IoTCloudStudio/HW_Develop/Productivo/Comunicador Connect/Configuracion OpenWRT/Migracion Claro MF193/LEEME.txt

========================================================================
 MIGRACION DE ROUTER A 3G (Claro)  -  ZTE MF193  -  por QMI
========================================================================

Para el tecnico en el sitio (NO necesita internet):

  1. Conecte la PC por WiFi a la red del router.
  2. Abra esta carpeta y haga doble clic en  INSTALAR.bat
  3. Responda lo que pregunta la ventana negra:
       - IP del router  -> si no sabe, apriete ENTER (usa 192.168.1.1)
       - Operador       -> 1 = Claro (por defecto)
     La contrasena del router va incluida: normalmente NO hay que escribir
     nada mas. Solo la pide si el router tiene otra contrasena.
  4. Espere unos 3-6 minutos SIN cerrar la ventana. El router configura el
     modem por QMI y prueba el 3G solo; el instalador se reconecta para ver
     como salio (mientras aparecen puntos "...", es normal).
     Al final dice "EL ROUTER NAVEGA POR 3G (QMI...)" o, si algo fallo,
     que hacer.

CONEXION POR WiFi: si la PC se desconecta de la red del router y NO vuelve
sola, reconectala a mano; la ventana sigue esperando. Si ya se cerro o dio
timeout, hace doble clic en  VER-RESULTADO.bat  : se reconecta y te dice
como salio, sin reinstalar nada.

Si Windows pregunta por "plink.exe" o "pscp.exe" (son de PuTTY, estan
firmados): permitir la ejecucion.

SI ALGO FALLA, SIMPLEMENTE VOLVE A HACER DOBLE CLIC EN INSTALAR.bat.
El instalador trabaja por etapas (paquetes / script / interfaz 3G / conexion
/ VPN) y cada una se valida contra el estado real del router, no contra lo
que paso la vez anterior. Lo que ya quedo bien NO se vuelve a instalar ni se
reconfigura - solo se reintenta lo que todavia no esta validado. Al final
siempre aparece el detalle etapa por etapa; si falta algo, el mensaje te
dice exactamente cual volver a intentar.
Si ves "YA HAY UNA INSTALACION EN CURSO": no se hizo nada mal, es que el
router todavia esta terminando la corrida anterior (u otra ventana del
instalador esta activa). Esperá 2-3 minutos y usá VER-RESULTADO.bat.

Si termina con problema: al lado de INSTALAR.bat queda un archivo
  instalacion-AAAAMMDD-HHMMSS.log
Mande ESE archivo a soporte. El router NO se retira: la configuracion
anterior queda respaldada dentro del router en
  /etc/config/network.original-antes-de-instalar

------------------------------------------------------------------------
 Que deja instalado en el router
------------------------------------------------------------------------
  - Modulos QMI (kmod-usb-net-qmi-wwan + deps) y el binario uqmi.
  - /usr/sbin/mf193-qmi  : conecta el modem por QMI y lo vigila.
      * en el arranque (rc.local) hace 'mf193-qmi connect'
      * cron cada 4 min hace 'mf193-qmi watch': si no hay internet
        reconecta, y si falla 3 veces seguidas REINICIA el router.
  - Interfaz 'wan3g' = proto 'dhcp' sobre 'wwan0', en la zona wan del
    firewall. netifd hace el DHCP, la ruta y el DNS.

------------------------------------------------------------------------
 Contenido de la carpeta
------------------------------------------------------------------------
  INSTALAR.bat          Lo unico que se toca (doble clic).
  VER-RESULTADO.bat     Solo re-lee como salio (si el WiFi se corto).
  instalar.ps1          Logica de la PC (PowerShell). Los .bat la lanzan.
  tools/                plink.exe + pscp.exe (PuTTY 0.85, sin instalar).
  mf193-offline-pkgs/   Se copia al router y se instala ahi, sin red:
                          - uqmi, qmi.sh, mf193-qmi
                          - kmods QMI + usb-modeswitch (.ipk)
                          - install-offline.sh (corre en el router)

------------------------------------------------------------------------
 Datos / notas
------------------------------------------------------------------------
- Router : TL-MR3020 v3  |  OpenWrt 22.03.0  |  target ramips/mt76x8
- Modem  : ZTE MF193 (arranca en modo 'factory_test'; se destraba por QMI
           con 'set-device-operating-mode online'). NO conecta por PPP.
- APN    : Claro = igprs.claro.com.ar (sin usuario/clave)
- PC     : Windows 10/11. NO necesita "Cliente OpenSSH" (usa tools/).
- Contrasena SSH del router (de fabrica): 3gC0nn3ct!
- Los .ipk/uqmi son de ESTE target (ramips/mt76x8, kernel 5.10.138). Otro
  modelo de router -> rearmar mf193-offline-pkgs/ con lo de ese target.
