IoTCloudStudio/HW_Develop/Productivo/Comunicador Connect/Documentacion tecnica/3G-Connect-MellanoSeguridad_V1.0.pdf

# Documento Técnico

## VPN Mellano Seguridad Versión: 1.00 - Fecha: 29-09-2022

## Descripción del documento

Este documento tiene como objetivo informar y documentar la VPN extendida a Mellano Seguridad como así también los parámetros configurados en los comunicadores 3G Connect.

## Detalle de la configuración Servidor

Se debera utilizar el soft: https://openvpn.net/community-downloads/

Cargar el certificado y usar las siguientes credenciales:

## OpenVPN

| Username | Password
Servidor | Mellano_server | DamianMe11ano2022

*** Recordar que con estas credenciales se puede acceder de a 1 Pc por vez

## Detalle de la configuración Comunicadores

IPs externos: 10.2.2.XXX

*** Donde XXX son los ultimos 3 numeros de la terminación de la etiqueta (SN situado en la zona inferior de los equipos)

Rango IP internos (Posee DHCP): 192.168.0.2-192.168.0.254

## WiFi

SSID | Password
IoTCloud-MellanoSeguridad | m3114n0s3gur1d4d

Servicios

Servicio | Puerto Externo | IP interno | Puerto Interno
Zkteco Viejas | 4370 | 192.168.0.10 | 4370
| 4371 | 192.168.0.11 | 4370
| 4372 | 192.168.0.12 | 4370
| 4373 | 192.168.0.13 | 4370
Zkteco Nuevas | 8088 | 192.168.0.10 | 8088
| 8089 | 192.168.0.11 | 8088
| 8090 | 192.168.0.12 | 8088
| 8091 | 192.168.0.13 | 8088
