IoTCloudStudio/HW_Develop/Productivo/Cloud UPS/Brochure/FOLLETO CLOUD UPS.png

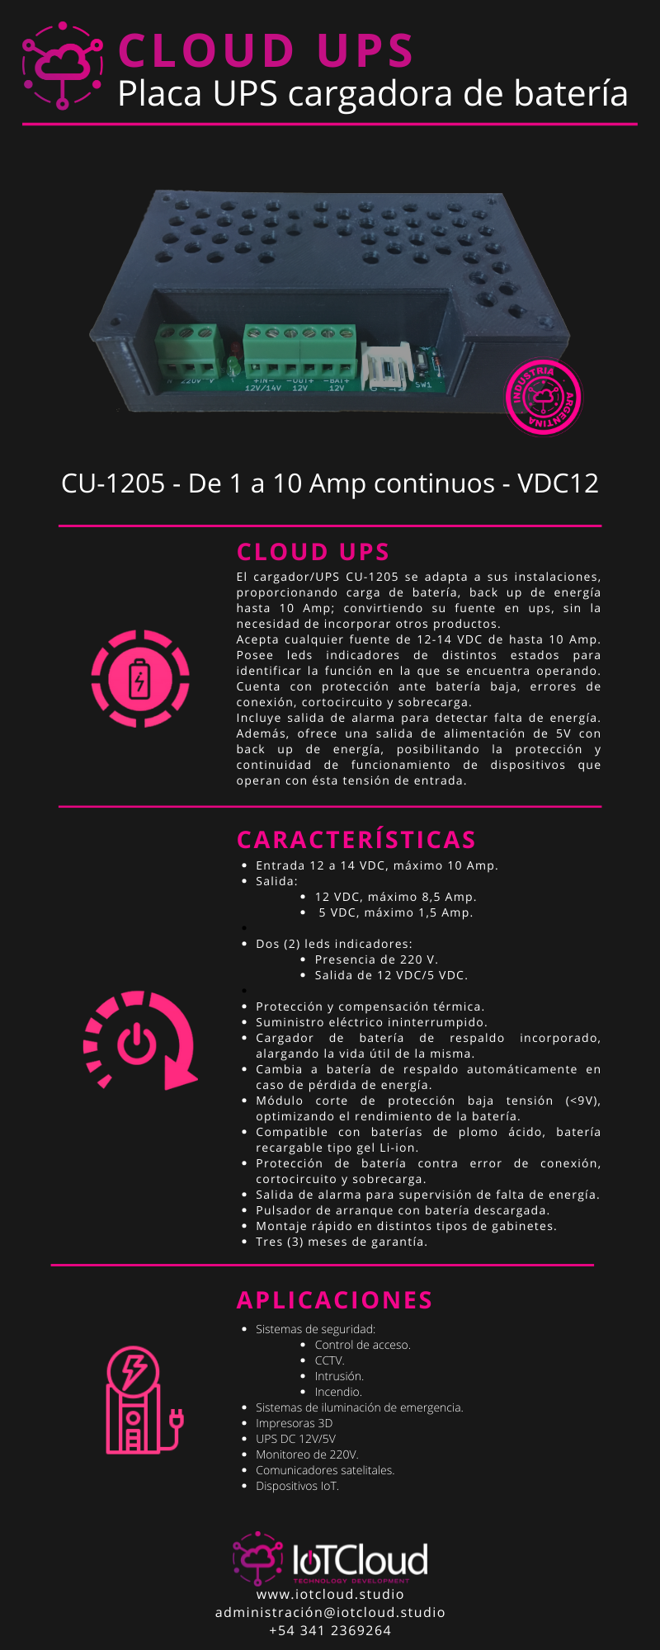
Productivo/Cloud UPS/Brochure/FOLLETO CLOUD UPS.png
