IoTCloudStudio/HW_Develop/Productivo/Comunicador Connect/Case/PNG/44cd3f2919015212b32772a9f72a4f9e.png

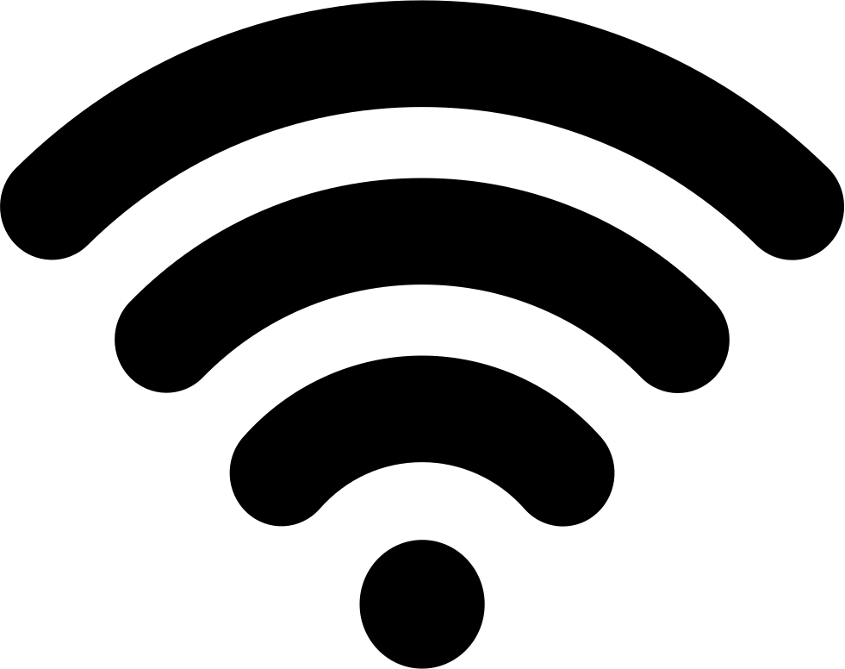
Productivo/Comunicador Connect/Case/PNG/44cd3f2919015212b32772a9f72a4f9e.png
