IoTCloudStudio/HW_Develop/Productivo/Comunicador Connect/Case/PNG/3753385.png

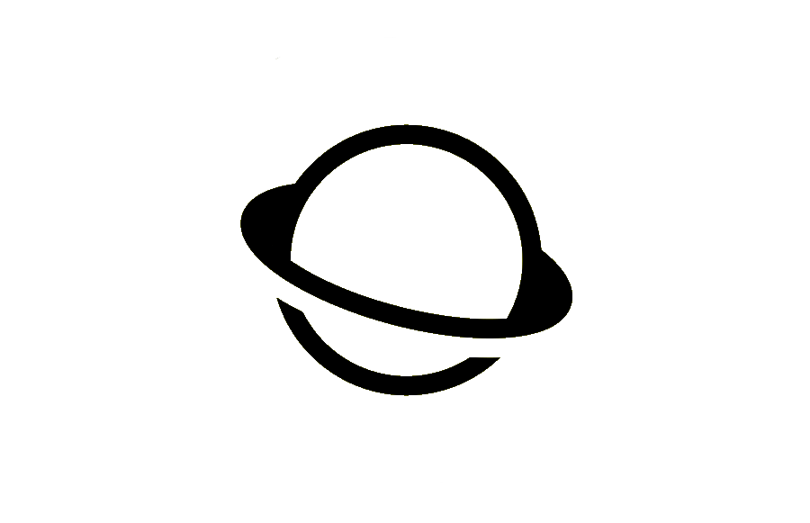
Productivo/Comunicador Connect/Case/PNG/3753385.png
