IoTCloudStudio/HW_Develop/Productivo/Comunicador Connect/Case/PNG/g3762.png

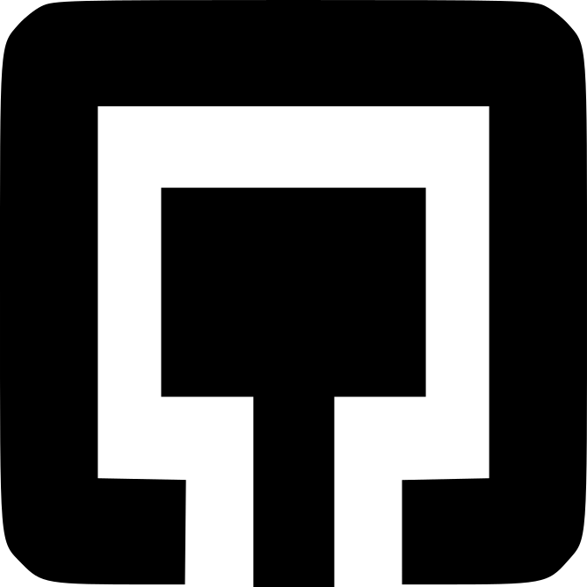
Productivo/Comunicador Connect/Case/PNG/g3762.png
