IoTCloudStudio/HW_Develop/Testing/Control de Acceso/lista componentes.xls

Sheet: Sheet1
 |  | cant | $/unid | iva | $ total s/iva | $ total c/iva | STOCK
R1, R2, R7, R8 | 2K2 | 4 | 3.3 | 21 | 13.20 | 15.97 | 59
R3 | 330 | 1 | 3.3 | 21 | 3.30 | 3.99 | 90
R4, R5 | 68K 2W | 2 | 13.2 | 21 | 26.40 | 31.94 | 8
R6 | 180 | 1 | 3.3 | 21 | 3.30 | 3.99 | 90
R9, R10, R11 | 10K | 3 | 3.3 | 21 | 9.90 | 11.98 | 55
RV1, RV2 | Trimmer 10k | 2 | 115.5 | 21 | 231.00 | 279.51 | 18
C1, C2 | 100 nF | 2 | 5.632 | 21 | 11.26 | 13.63 | 12
C3 | 33 uF | 1 | 8.03 | 21 | 8.03 | 9.72 | 8
C3 | 1 uF | 1 | 4.6816 | 21 | 4.68 | 5.66 | 12
D1 | Puente W10M | 1 | 33.44 | 10.5 | 33.44 | 36.95 | 2
D2, D6, D10 | 1n4148 | 3 | 0.99 | 10.5 | 2.97 | 3.28 | 0
D3, D4 | 1n5408 | 2 | 15.1492 | 10.5 | 30.30 | 33.48 | 6
D5 | Led verde | 1 | 5.808 | 10.5 | 5.81 | 6.42 | 10
D7 | Led rojo | 1 | 5.72 | 10.5 | 5.72 | 6.32 | 10
D8 | Zener 11V | 1 | 4.928 | 10.5 | 4.93 | 5.45 | 0
D9 | Zener 6,8V | 1 | 4.9247 | 10.5 | 4.92 | 5.44 | 0
Q1 | IRF630N | 1 | 121 | 10.5 | 121.00 | 133.71 | 0
Q2, Q3 | BC548 | 2 | 5.984 | 10.5 | 11.97 | 13.22 | 8
Q4 | BC557 | 1 | 6.105 | 10.5 | 6.11 | 6.75 | 15
K1 | Rele 2 Inv | 1 | 110 | 21 | 110.00 | 133.10 | 3
K2 | Rele 1 Inv | 1 | 154 | 21 | 154.00 | 186.34 | 23
U1 opto | PC817 | 1 | 28.6 | 10.5 | 28.60 | 31.60 | 2
U2 (zocalo) | Zocalo dip 8 | 1 | 5.5 | 21 | 5.50 | 6.66 | 0
U3 reg | LM7805 | 1 | 40.7 | 10.5 | 40.70 | 44.97 | 7
SET1 | PULSADOR | 1 | 11 | 10.5 | 11.00 | 12.15 | 5
 | BORNERA x3 | 3 | 52.8 | 10.5 | 158.40 | 175.03 | 45
 | HEADER 90 x4 | 1 | 5.984 | 21 | 5.98 | 7.24 | 10
U2 (chip) | NE555 | 1 | 22 | 10.5 | 22.00 | 24.31 | 0
 | DISIPADOR 555 | 1 | 53 | 21 | 53.00 | 64.13 | 3
 | DISIPADOR IRF | 1 | 53 | 21 | 53.00 | 64.13 | 2
 | HOUSING x4 | 1 | 3.426 | 21 | 3.43 | 4.15
 | Pines p/housing | 4 | 1.98 | 21 | 7.92 | 9.58 | 100
total |  |  |  |  | 1191.77 | 1390.81

Sheet: Sheet2
 | Caracteristica | Cantidad
Cap ceramico | 100nF | 50
Cap electr radial | 1uF 63v 5x11 | 20
Cap electr radial | 33uF 63v 8x12 | 20
Puente rectificador | W10M | 25
Diodo | 1n4148 | 100
Diodo | 1n5408 | 50
Led | 3mm Verde difuso | 20
Led | 3mm Rojo difuso | 20
Diodo zener | 11v 1/2w | 25
Diodo zener | 6v8 1/2w | 25
Rele | S. inv. 12V 10A | 20
Rele | D. inv. 12V 1A | 20
Mosfet | IRF630 | 23
Transistor | BC548B | 40
Transistor | BC557 | 10
Resistencia metal-film | 2k2 1/2w | 100
Resistencia metal-film | 10k 1/2w | 100
Resistencia metal-film | 68k 2w | 50
Llave tact switch | mini 5.1mm 2 patas | 25
Optoacoplador | PC817 | 25
Circuito integrado | NE555 | 30
Regulador de voltaje | LM7805 | 20
Header | .1' 90° Macho 4 vias | 20
Terminal crimpeable | p/ housing .1' 1 cara de contacto | 100
Trimpot cermet 1 vuelta | 10k horizontal | 50
Zocalo para C.I. | 2x4 | 25
Bornera apilable verde | 3 polos 10a (tornillo ranura plana) | 60
