IoTCloudStudio/HW_Develop/Productivo/Cloud UPS/Imagenes/PCB v1.0 - Materiales.jpg

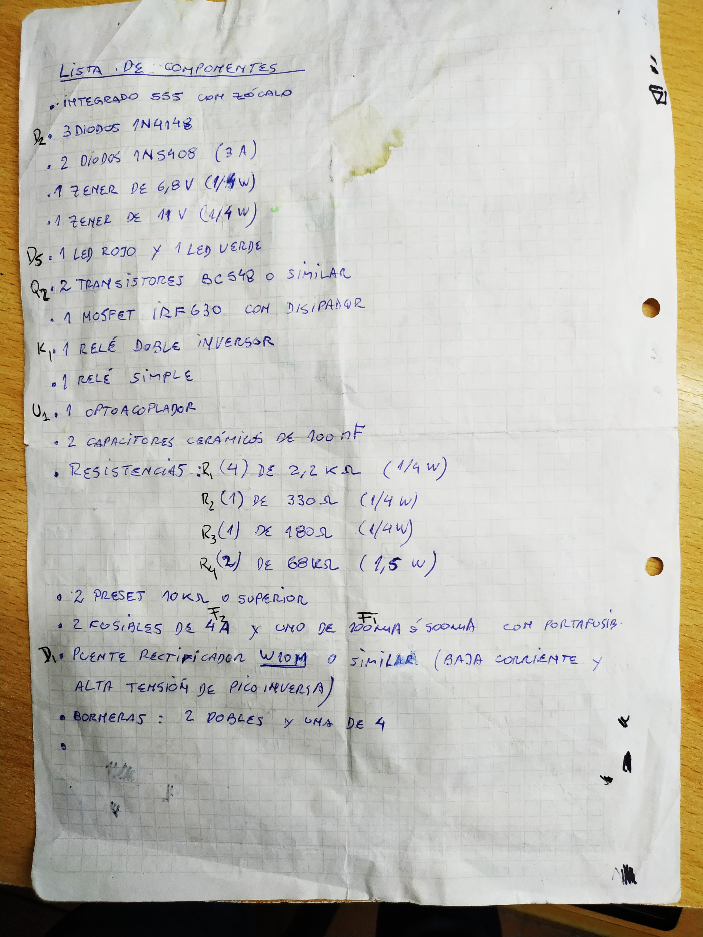
Productivo/Cloud UPS/Imagenes/PCB v1.0 - Materiales.jpg
