IoTCloudStudio/HW_Develop/Productivo/Cloud UPS/Case/tapa upsV1.3.STL

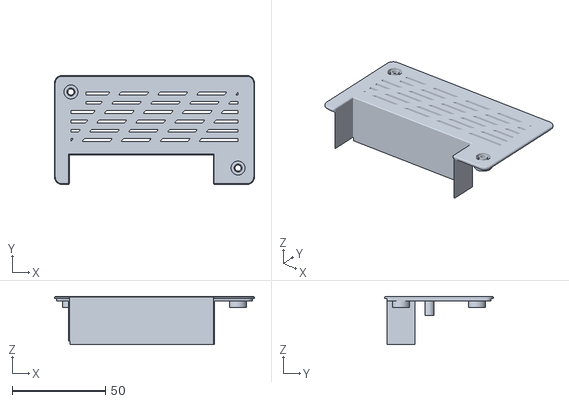
[picture p12: CAD file, 2022-12-19]
Productivo/Cloud UPS/Case/tapa upsV1.3.STL
107.0 x 58.3 x 25.7
