IoTCloudStudio/HW_Develop/Testing/Control de Acceso/PCB_control_acceso/PCB_control_acceso-B_Cu.dxf

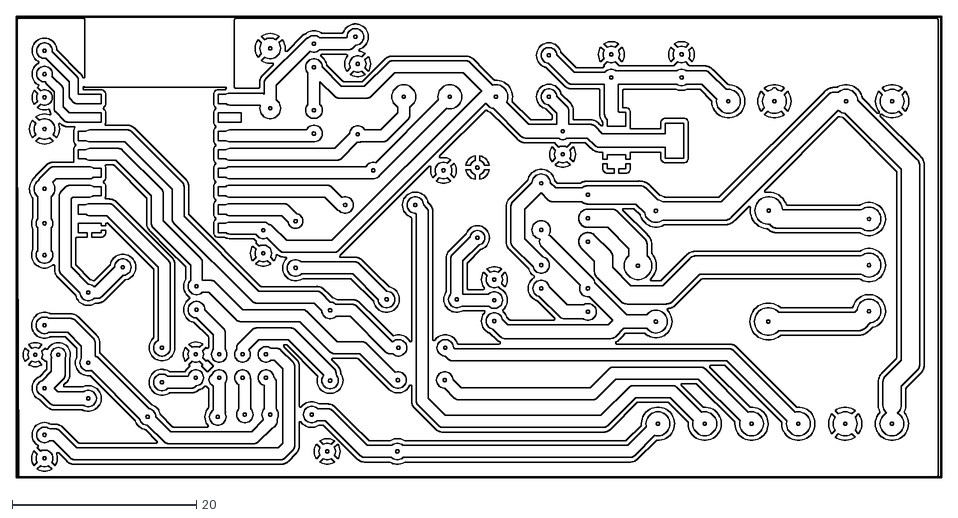
[picture p13: CAD file, 2024-07-27]
Testing/Control de Acceso/PCB_control_acceso/PCB_control_acceso-B_Cu.dxf
100.4 x 50.1
