IoTCloudStudio/HW_Develop/Productivo/Cloud UPS/Case/base ups.SLDPRT

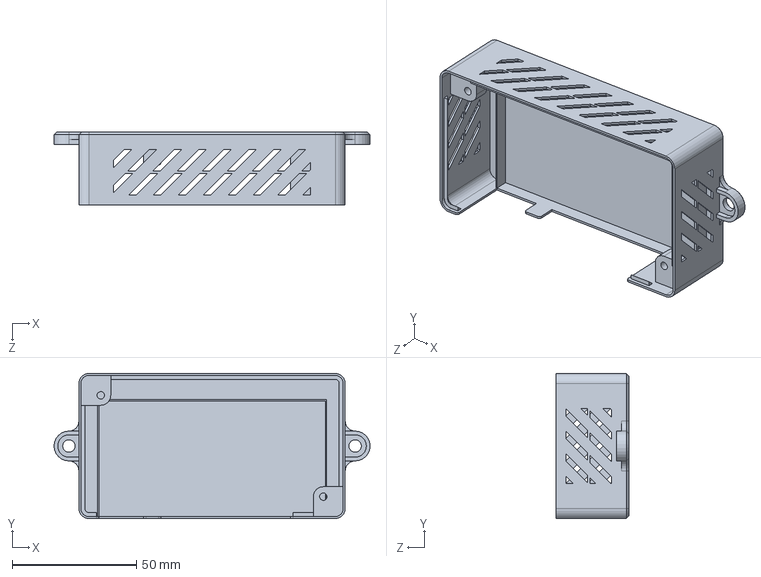
[picture p14: CAD file, 2022-12-19]
Productivo/Cloud UPS/Case/base ups.SLDPRT
127.0 x 58.3 x 29.2 mm
