IoTCloudStudio/HW_Develop/Productivo/Cloud UPS/Case/tapa ups.STL

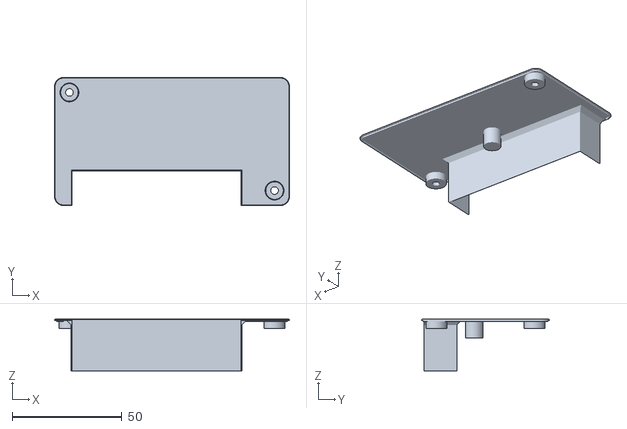
[picture p15: CAD file, 2022-12-19]
Productivo/Cloud UPS/Case/tapa ups.STL
107.0 x 58.3 x 23.6
