IoTCloudStudio/HW_Develop/Productivo/Comunicador Connect/Case/iot3g_chico.SLDPRT

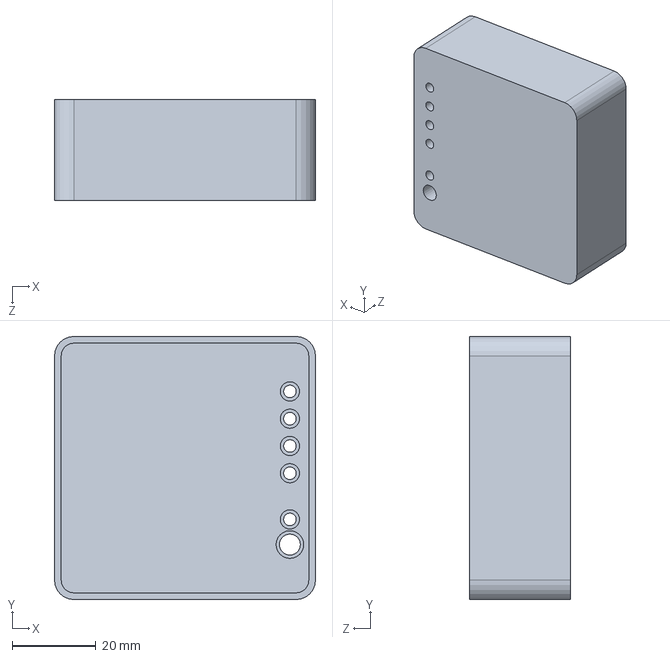
[picture p16: CAD file, 2022-12-19]
Productivo/Comunicador Connect/Case/iot3g_chico.SLDPRT
62.2 x 62.7 x 24.1 mm
