IoTCloudStudio/HW_Develop/Productivo/Comunicador Connect/Case/iot3g-v1-1.SLDPRT

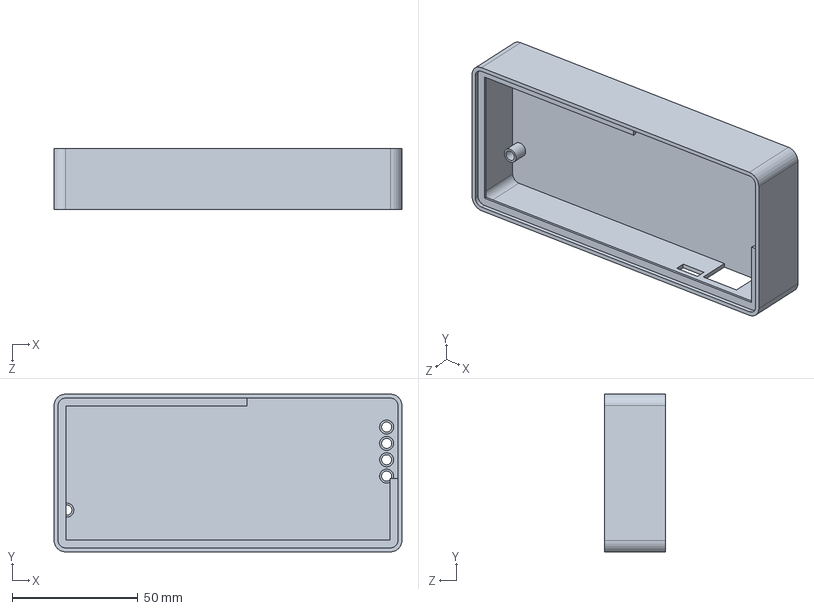
[picture p17: CAD file, 2022-12-19]
Productivo/Comunicador Connect/Case/iot3g-v1-1.SLDPRT
138.2 x 62.7 x 24.1 mm
