IoTCloudStudio/HW_Develop/Productivo/Comunicador Connect/Case/case-3gGrandeV9.STL

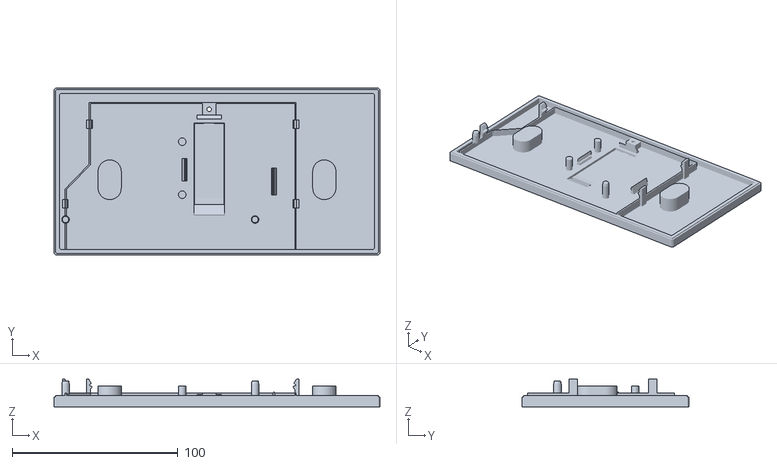
[picture p18: CAD file, 2022-12-19]
Productivo/Comunicador Connect/Case/case-3gGrandeV9.STL
196.8 x 100.8 x 16.7
