IoTCloudStudio/HW_Develop/Productivo/Comunicador Connect/Case/iot3g.SLDPRT

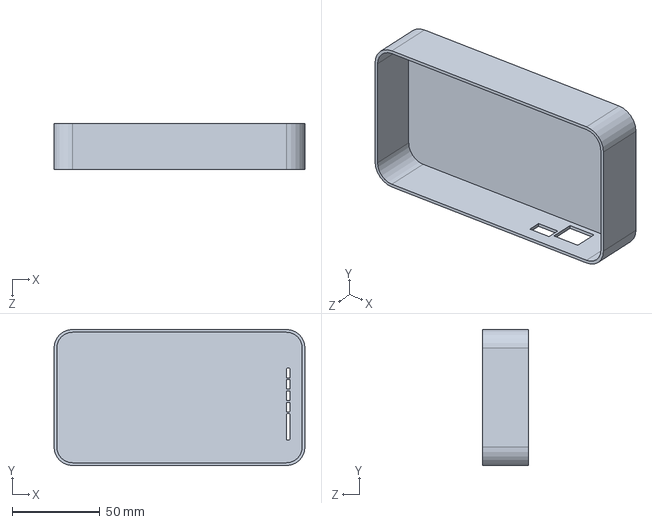
[picture p20: CAD file, 2022-12-19]
Productivo/Comunicador Connect/Case/iot3g.SLDPRT
143.2 x 77.7 x 26.1 mm
