IoTCloudStudio/HW_Develop/Productivo/Comunicador Connect/Case/3giot tapa.stl

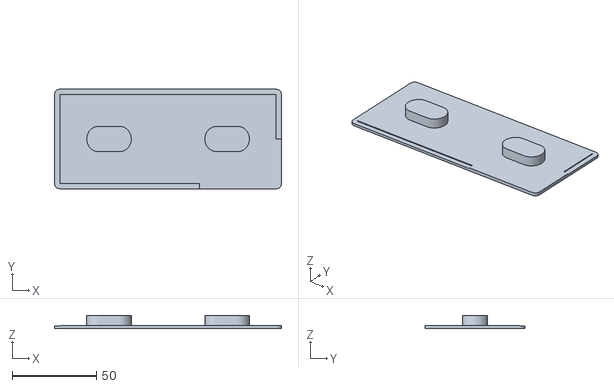
[picture p21: CAD file, 2022-12-19]
Productivo/Comunicador Connect/Case/3giot tapa.stl
134.5 x 59.0 x 7.84
