IoTCloudStudio/HW_Develop/Productivo/Comunicador Connect/Case/case-3gGrandeV9tapa.STL

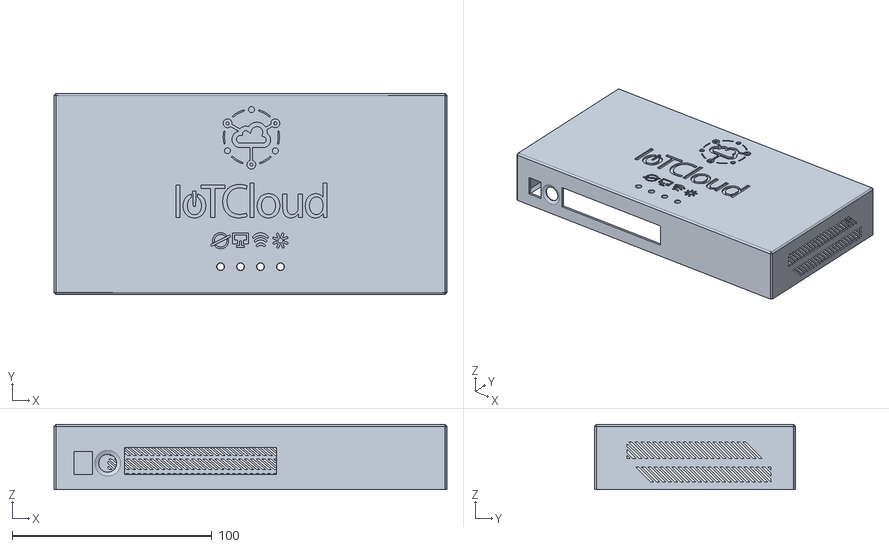
[picture p22: CAD file, 2022-12-19]
Productivo/Comunicador Connect/Case/case-3gGrandeV9tapa.STL
196.8 x 100.8 x 32.6
