IoTCloudStudio/HW_Develop/Productivo/Comunicador Connect/Case/3giot (3).stl

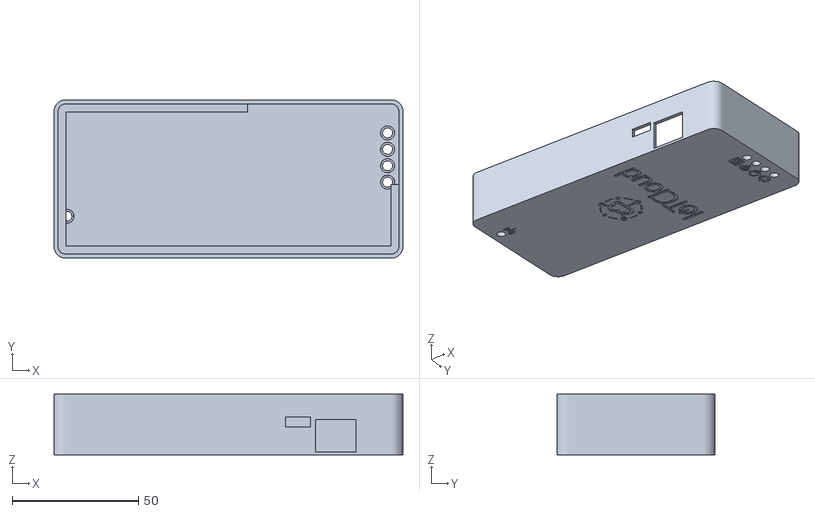
[picture p23: CAD file, 2022-12-19, an earlier design]
Productivo/Comunicador Connect/Case/3giot (3).stl
138.2 x 62.7 x 24.1
