IoTCloudStudio/HW_Develop/Productivo/Comunicador Connect/Case/3giot (4).stl

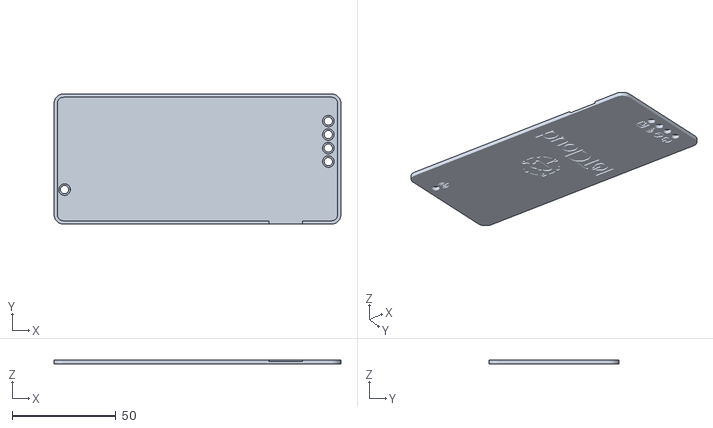
[picture p24: CAD file, 2022-12-19, an earlier design]
Productivo/Comunicador Connect/Case/3giot (4).stl
138.2 x 62.7 x 2.00
