IoTCloudStudio/HW_Develop/(list of files, cad)

Other CAD files:
Productivo/Comunicador Connect/Case/iot3g-v1-0.STL
Productivo/Comunicador Connect/Case/iot3g-nuevo.SLDPRT
Productivo/Comunicador Connect/Case/3giot.stl
Productivo/Comunicador Connect/Case/3giot (5).stl
Productivo/Comunicador Connect/Case/3giot (2).stl
Productivo/Cloud UPS/Case/base ups.STL
Productivo/Comunicador Connect/Case/3giot (1).stl
Productivo/Comunicador Connect/Case/iot3g-v1-1.STL
Productivo/Comunicador Connect/Case/iot3g-v1.0.SLDPRT
Productivo/Comunicador Connect/Case/iot3g-v1.0.STL
Productivo/Comunicador Connect/Case/iot3g-v1.1.STL
Productivo/Comunicador Connect/Case/iot3g.STL
Productivo/Comunicador Connect/Case/iot3g_chico.STL
Testing/Control de Acceso/PCB_control_acceso/PCB_control_acceso-B_Mask.dxf
