IoTCloudStudio/HW_Develop/Testing/Caravana RFID/ESP32_RFID_Reader/extras/antennaFreq.xlsx

Sheet: Sheet1
Antenna Calcs | Value | Units
Required Freq | 134.2 | kHz
Inductor | 0.41 | mH
Required Cap | 3.4 | nF
Actual Cap | 3.4 | nF
Actual Freq | 134.8 | kHz
Equations
Required Cap | 3.430452221
Actual Freq | 134.7996438

Sheet: Sheet2
diameter | 0.11
radius | 5.5
width | 0.5
windings | 44
inductance | 36.48287269
 | 5.885829146
