IoTCloudStudio/HW_Develop/Testing/Harvesting energy/Data/Cleaned_data.xlsx

Sheet: V1_Experiment1-4
Sequence number | Baseline (HEX) | Basline (DEC) | Baseline (From 0) | Exp 1 (HEX) | Exp 1 (DEC) | Exp 1 (From 0) | Exp 2 (HEX) | Exp 2 (DEC) | Exp 2 (From 0) | Exp 3 (HEX) | Exp 3 (DEC) | Exp 3 (From 0) | Exp 4 (HEX) | Exp 4 (DEC) | Exp 4 (From 0)
1 | 0c78 | 3192 | 0 | 0c25 | 3109 | 0 | 0c0c | 3084 | 0 | 0c2c | 3116 | 0 | 0c6b | 3179 | 0
2 | 0c73 | 3187 | -5 | 0c22 | 3106 | -3 | 0c12 | 3090 | 6 | 0c29 | 3113 | -3
3 | 0c6b | 3179 | -13 | 0c1c | 3100 | -9 |  |  |  | 0c43 | 3139 | 23
4 | 0c64 | 3172 | -20 | 0c17 | 3095 | -14 | 0c12 | 3090 | 6
5 | 0c5f | 3167 | -25 | 0c17 | 3095 | -14
6 | 0c5b | 3163 | -29 | 0c17 | 3095 | -14 | 0c07 | 3079 | -5
7 | 0c53 | 3155 | -37 | 0c12 | 3090 | -19
8 |  |  |  | 0c0c | 3084 | -25 | 0c03 | 3075 | -9
9 | 0c4a | 3146 | -46 | 0c09 | 3081 | -28 |  |  |  | 0c7c | 3196 | 80
10 |  |  |  | 0c07 | 3079 | -30
11
12 | 0c3a | 3130 | -62 |  |  |  | 0bf3 | 3059 | -25 | 0c7a | 3194 | 78
13 |  |  |  | 0bf7 | 3063 | -46 | 0bec | 3052 | -32 | 0c75 | 3189 | 73
14 | 0c30 | 3120 | -72 | 0bf7 | 3063 | -46 | 0bf1 | 3057 | -27
15 | 0c2c | 3116 | -76 | 0bf1 | 3057 | -52
16 | 0c25 | 3109 | -83 | 0bee | 3054 | -55
17 | 0c20 | 3104 | -88
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
