IoTCloudStudio/HW_Develop/Testing/Harvesting energy/Data/Raw data/V1/Experiment4_raw.xlsx

Data | Operator | Sequence number | Timestamp
0bd8 | SIGFOX_Denmark_IOTDK | 110 | 24/02/2022 11:52
0bf5 | SIGFOX_Denmark_IOTDK | 103 | 23/02/2022 07:35
0c30 | SIGFOX_Denmark_IOTDK | 80 | 20/02/2022 22:48
0c6b | SIGFOX_Denmark_IOTDK | 63 | 18/02/2022 05:50
0d4f | SIGFOX_Denmark_IOTDK | 1 | 2022-07-02 06:10
 |  |  |  | f
