IoTCloudStudio/HW_Develop/Testing/Caravana RFID/RDM6300/RDM6300_PCB.png

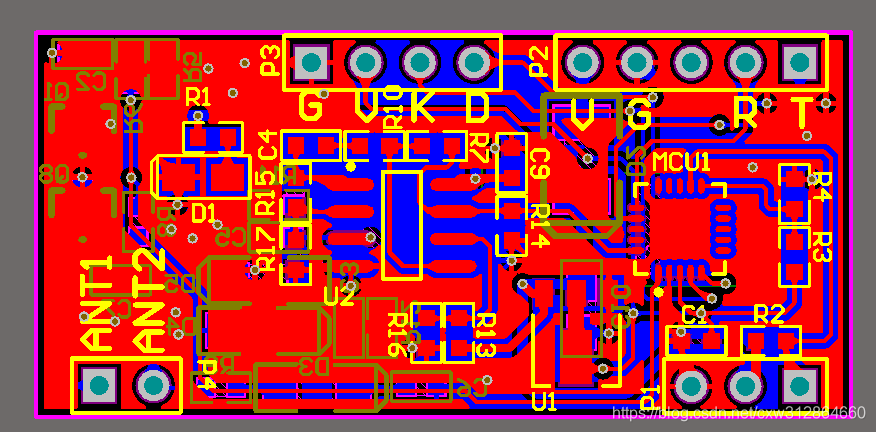
Testing/Caravana RFID/RDM6300/RDM6300_PCB.png
