IoTCloudStudio/HW_Develop/Testing/Testing Emiliano/PCB_REGULADOR_SOLAR/pcb_regulador_solar_V1.0/PCB_Emiliano.jpeg

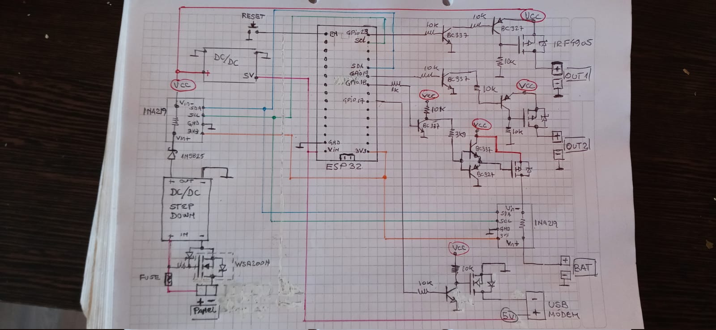
Testing/Testing Emiliano/PCB_REGULADOR_SOLAR/pcb_regulador_solar_V1.0/PCB_Emiliano.jpeg
