IoTCloudStudio/HW_Develop/Testing/Testing Emiliano/PCB_REGULADOR_SOLAR/pcb_regulador_solar_V1.0/Preliminares/MODULOS.jpeg

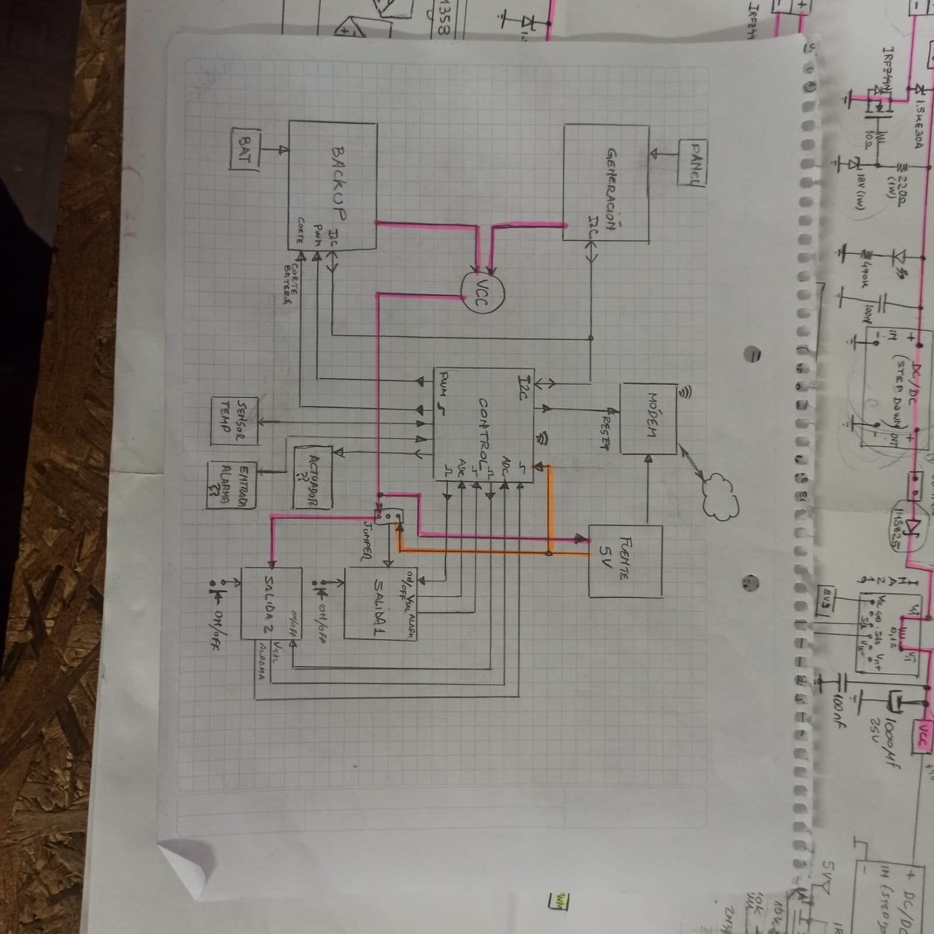
Testing/Testing Emiliano/PCB_REGULADOR_SOLAR/pcb_regulador_solar_V1.0/Preliminares/MODULOS.jpeg
