IoTCloudStudio/HW_Develop/Testing/Control de Acceso/PCB_control_acceso/PCB_control_acceso-B_Cu.pdf

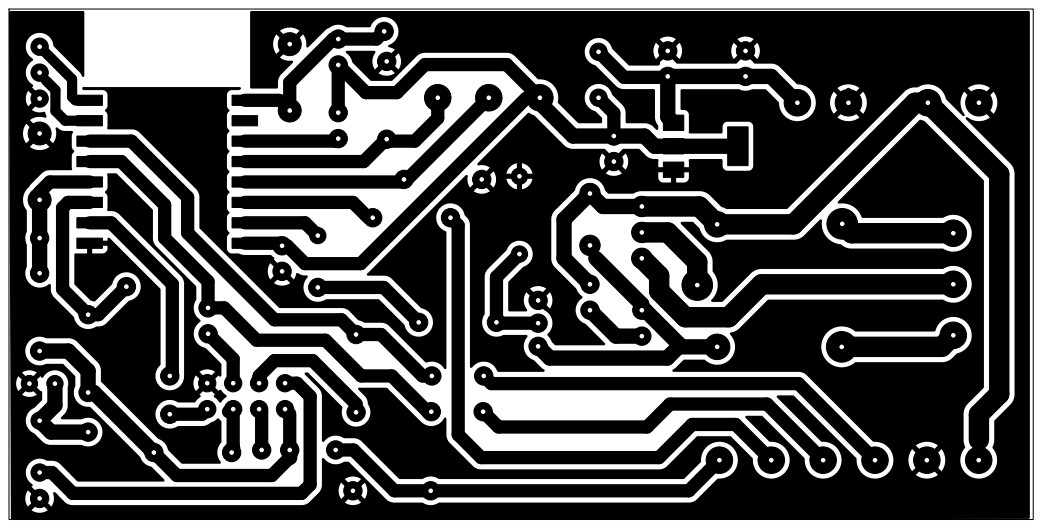
[picture p79: page 1]
