IoTCloudStudio/HW_Develop/Testing/Control de Acceso/PCB_control_acceso/PCB_control_acceso-B_Mask.pdf

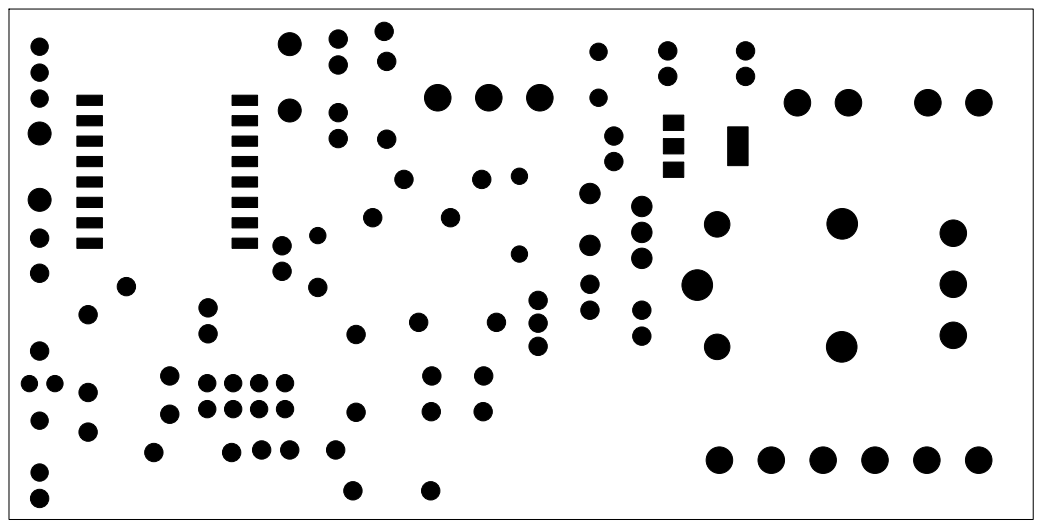
[picture p80: page 1]
