IoTCloudStudio/HW_Develop/Productivo/Tesseract/PCB/Tesseract/CAPA B.pdf

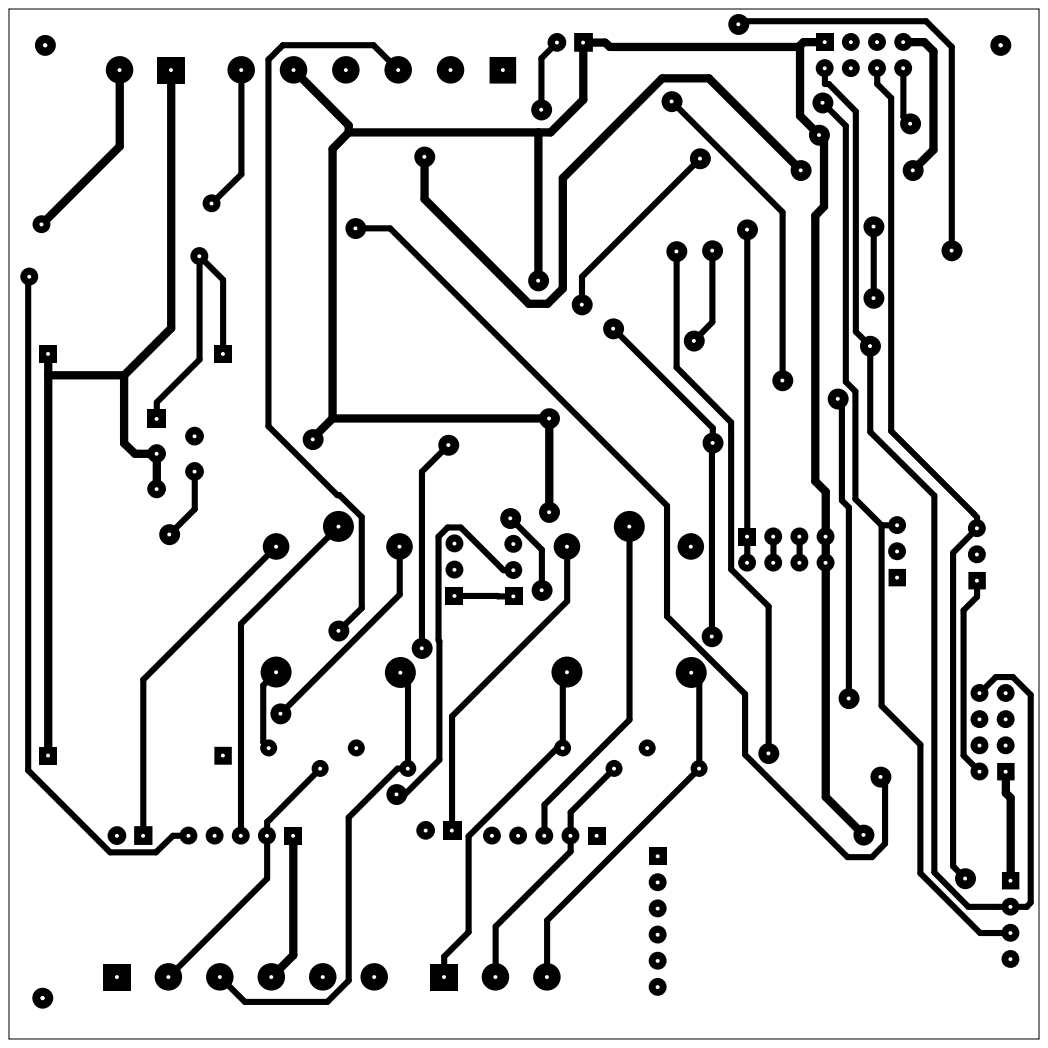
[picture p81: page 1]
