IoTCloudStudio/HW_Develop/Productivo/Tesseract/PCB/Tesseract/CAPA F.pdf

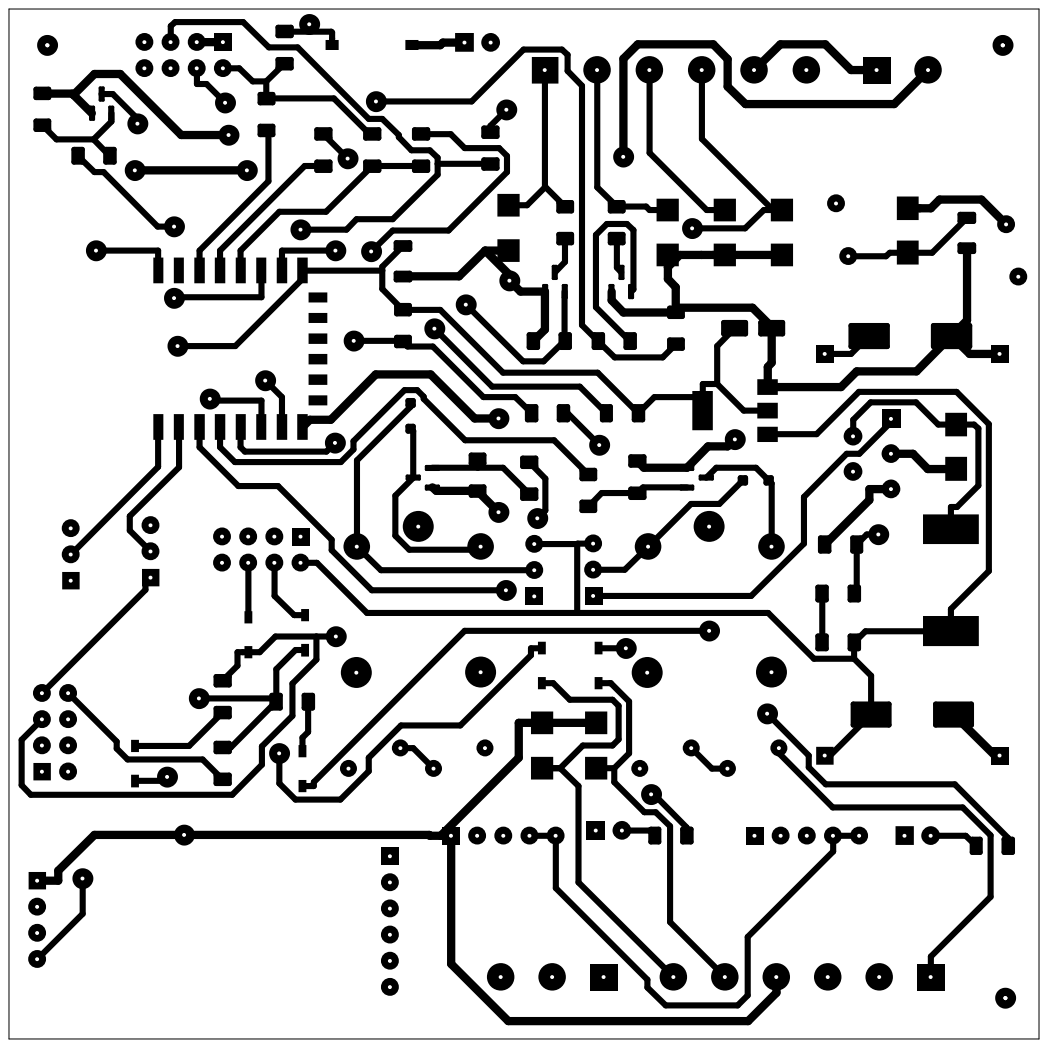
[picture p82: page 1]
