IoTCloudStudio/HW_Develop/(list of files, drawings)

Other design files:
Productivo/Cloud UPS/OLD PCB/UPS.dsn
Productivo/Comunicador Connect/PCB/Ruteador.dsn
Productivo/Comunicador Connect/PCB/SIM/Ruteador2.dsn
Productivo/Comunicador Connect/PCB/SIM/Ruteador.dsn
Productivo/Tesseract/PCB/Tesseract/Tesseract.dsn
