IoTCloudStudio/HW_Develop/Productivo/Comunicador Connect/Configuracion OpenWRT/config_OpenWRT_V1.0.txt

Installing TFTP Server :
(Linux)
sudo apt update
sudo apt install tftpd-hpa
sudo systemctl status tftpd-hpa

(WIN)
En Win hay que buscar el instalador openTFTP guardado

---------------------------------------------------

Configure un servidor TFTP de la siguiente manera:

Dirección IP 192.168.0.225
El archivo tp_recovery.bin se encuentra en la misma carpeta de este instructivo

Debemos colocar el tp_recovery.bin en el directorio :
(Linux) /srv/tftp/ 
(WIN revisar carpeta por default en el config del server, de no existir debera crearse una) C:\OpenTFTPServer\tp_recovery.bin

Iniciar o revisar que el servidor TFTP este INICIADO

---------------------------------------------------

Instalar OpenWrt

Conectado al mr3020v3 a través de una conexión por cable
Apague el mr3020v3
Mantenga presionado el botón "restablecer": se encuentra junto a la fila de luces en el panel superior
Aplique alimentación USB al mr3020v3 mientras mantiene presionado el botón de reinicio
Después de 20-30 segundos, la carga estará completa, suelte el botón de reinicio
La imagen OpenWrt ahora se cargará en el dispositivo. 

---------------------------------------------------

Por defecto, la conexión inalámbrica estará deshabilitada. El sistema estará disponible en su interfaz cableada en 192.168.1.1.

Ingresar al chrome IP 192.168.1.1:
user: root
pass: 1234

En el menu system/administration grabar pass "3gC0nn3ct!" y logout. 
Volver a ingresar para probar credenciales nuevas.
Conectar a internet (menu Network/wireless) 
Entrar interfaces, editar WWAN, en advanced destildar "Use DNS servers advertised by peer" y ponerle custom DNS 8.8.8.8
Menu Network/Firewall: forward, input y foward accept.

Ingresar por SSH (ssh root@192.168.1.1)
opkg update
opkg install comgt kmod-usb2 kmod-usb-ohci kmod-usb-uhci kmod-usb-serial kmod-usb-serial-option kmod-usb-serial-wwan kmod-usb-acm usb-modeswitch luci-proto-3g
opkg install openvpn-openssl luci-app-openvpn 

Crear interfaz "tun0" protocol ummanaged Device "tun0"
editarla y en la solapa firewall: debera estar cargada wan y tun0


reboot (Reiniciar el dispositivo)!!!!!!!


Crear interfaz 3GWAN, Protocol: UMTS/GPRS/EV-DO. Una vez aplicados los cambios editar la misma interfaz dial number *99# y en la solapa firewall elegir WAN
Tener en cuenta que si el modem es Huawei elegir USB2 o ZTE USB4

Ir a system/scheduled tasks:
# Reboot at 4:30am every day
# Note: To avoid infinite reboot loop, wait 70 seconds
# and touch a file in /etc so clock will be set
# properly to 4:31 on reboot before cron starts.
30 4 * * * sleep 70 && touch /etc/banner && reboot

---------------------------------------------------

Crear WIFI 


Solo para LOCK!!!!
Network/wireless Edit

SSID: JOIN-LOCK
Pass: L0ck3382!

-------

Equipos IoT Genericos!!!!
Network/wireless Edit

SSID: IoT_Cloud_XXX (donde XXX es el SN, por ejemplo: 010020020051)
Pass: Es el SN de atras para adelante (por ejemplo: 150020020010)


---------------------------------------------------

Ingresar al OPNSense

Crear usuario y tildar la opcion de crear certificado de usuario. En la proxima ventana, choose Existing certificate -> testing2
VPN-> OpenVPN -> Client Specific override
	Creamos un IP static para el user
Ir a exportar certificate y generar el archivo

En el dispositivo ir al menu VPN, OVPN configuration file upload:
Nombre: Mismo que el usuario
subir el Certificate OVPN

Editar
(al principio del archivo) Cambiar tun por tun0
(solo aparece la linea auth-user-pass que hay que agregarle) auth-user-pass /etc/openvpn/IoTcom60.auth

En el espacio en blanco abajo:
(nombre del usuario que creamos en el opnsense) IoTcom60
iotcloud

Guardar y volver a la pantalla de OVPN. Tildar enabled y start, save and apply

---------------------------------------------------

-CAmbiar Hostname en solapa system a "3G_Connect"
-Desactivar acceso web:
ssh root@10.2.2.X
/etc/init.d/uhttpd disable
/etc/init.d/uhttpd stop

---------------------------------------------------
Funcionalidades EXTRAS y troubleshooting:

(Solo usar para activar acceso WEB) 
ssh root@10.2.2.X
/etc/init.d/uhttpd enabled
/etc/init.d/uhttpd start


Desbloquear modem 3g

Buscar soft
ZTE Movistar. Recordar volver a conectar para activar
---------------------------------------------------

TESTING
sudo nmap -p 4370  10.2.2.65
sudo nmap -p 4370 -sU  10.2.2.65
