IoTCloudStudio/HW_Develop/(commit log)

2022-11-02 Ejemplo sensor de puerta, pub y sub mqtt
2022-11-02 Sensor de puerta
2022-11-03 sensor puerta
2022-11-07 Sensor puerta concejo
2022-12-14 Cambio de sonorizacion
2022-12-19 Sincro HW Develop
    [3giot (1).stl, 3giot (2).stl, 3giot (3).stl, 3giot (4).stl, 3giot (5).stl, 3giot tapa.stl, 3giot.stl, DefinicionPIN.ods]
2022-12-19 Interface DSC
    [WemosD1MiniShield.brd, WemosD1MiniShield.sch]
2023-01-19 Ajuste sonorizacion Buzzer 3v
    [Sensor_Puerta_Tablero.ino]
2023-02-01 First commit lector RFID
    [lista componentes.xls]
2023-02-23 ajustes locales en el concejo
2023-02-28 Agregado de delay extra de prueba con emiliano
2023-04-26 PCB solar
    [config_OpenWRT_V1.0.txt]
2023-05-05 Avance PCB Regulador solar
    [pcb_regulador_solar_V1.0.sch]
2023-06-22 HArvest energy clone
    [Cleaned_data.xlsx, Configuration.h, ConfigurationTest.h, Experiment1_raw.xlsx, Experiment2_raw.xlsx, Experiment3_raw.xlsx, Experiment4_raw.xlsx, Experiment5_journal.xlsx]
2023-09-27 PCB Regulador Solar
    [pcb_regulador_solar_V1.0.csv, pcb_regulador_solar_V1.0.kicad_sch]
2023-09-28 Etapa entrada
    [pcb_regulador_solar_V1.0.kicad_sch]
2023-09-28 Avance PCB UPS
    [pcb_regulador_solar_V1.0.csv, pcb_regulador_solar_V1.0.kicad_pcb, pcb_regulador_solar_V1.0.kicad_sch]
2023-09-29 Armado PCB
    [pcb_regulador_solar_V1.0.kicad_pcb, pcb_regulador_solar_V1.0.kicad_sch]
2023-10-24 actualizaciones pcb
2023-10-24 actualizacion pcb_regulador_solar
    [pcb_regulador_solar_V1.0.kicad_sch]
2024-02-02 Modulos PCB
    [pcb_módulo_control.kicad_sch, pcb_módulo_salida.kicad_sch, pcb_regulador_solar_V1.0.kicad_sch, pcm_módulo _energía.kicad_sch]
2024-02-08 cambios pcb
    [pcb_módulo_control.kicad_sch, pcb_módulo_salida.kicad_sch, pcm_módulo _energía.kicad_sch]
2024-07-03 pcb control acceso
    [PCB_control_acceso.kicad_pcb, PCB_control_acceso.kicad_sch]
2024-07-27 actualizacion 27/7/24
    [PCB_control_acceso-B_Cu.dxf, PCB_control_acceso-B_Mask.dxf, PCB_control_acceso.csv, PCB_control_acceso.kicad_pcb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]
2024-08-22 Tesseract cambio de testing a productivo/RFW26 a productivo
    [RFW26.kicad_pcb, RFW26.kicad_sch, Teseracto.kicad_pcb, Teseracto.kicad_sch]
2024-08-28 Diagrama PCB
    [RFW26.kicad_sch]
2024-08-30 agregado de fuente dcdc 5v
    [Teseracto.kicad_sch]
2024-08-30 cambios RFW26/ jumpers salida teseracto
    [RFW26.kicad_sch, Teseracto.kicad_sch]
2024-09-03 Agregado lista de materiales RFW26
    [RFW26.csv]
2024-09-10 CAmbio Huellas RFW26
    [RFW26.kicad_sch]
2024-09-10 Actualizacion pcb tesseracto
    [Teseracto.kicad_sch]
2024-09-11 AVANCE PCB
    [Teseracto.kicad_pcb, Teseracto.kicad_sch]
2024-09-11 alarma comunitaria
    [alarma_com.kicad_pcb, alarma_com.kicad_sch]
2024-09-16 agregué sim800l
    [Teseracto.kicad_pcb, Teseracto.kicad_sch]
2024-10-08 Nomenclador numeros de serie
2024-10-25 agregado proyecto caravana activa
    [antennaFreq.xlsx]
2024-10-28 Traduccion Tesseract
    [antennaFreq.xlsx]
2024-11-21 desarrollo PCB RFW26
    [RFW26.dsn, RFW26.kicad_pcb, RFW26.kicad_sch]
2024-12-06 saqué sim 800
    [Teseracto.kicad_sch]
2024-12-06 cambio diseño PCB
    [Teseracto.kicad_pcb, Teseracto.kicad_sch, Tesseract.dsn, Tesseract.kicad_pcb, Tesseract.kicad_sch]
2024-12-09 placa 1 capa RFW26
    [RFW26.dsn, RFW26.kicad_pcb, RFW26.kicad_sch, RFW26_1capa.dsn, RFW26_2Capas.kicad_pcb]
2024-12-20 Ruteo RFW26 1 capa
    [RFW26.kicad_pcb, RFW26.kicad_sch, RFW26_1capa.dsn]
2024-12-20 ruteo pcb
    [Tesseract.kicad_pcb, Tesseract.kicad_sch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]
2024-12-20 ajuste 2 capaz tesseract
    [Tesseract.kicad_pcb, Tesseract.kicad_sch]
2024-12-20 agregado de Fuente a tesseract
    [RFW26.kicad_pcb, Tesseract.kicad_sch]
2024-12-23 Ajustes de huellas y ruteo RFW26
    [RFW26.kicad_pcb, RFW26.kicad_sch]
2024-12-23 RFW26 1 CAPA conconexiones por fuera
    [RFW26.kicad_pcb, RFW26.kicad_sch]
2024-12-24 PCB menos de 10 pistas en freeroutin
    [RFW26.kicad_pcb]
2024-12-27 reacomodado de componentes
    [Tesseract.kicad_pcb, Tesseract.kicad_sch]
2025-01-06 RFW26 1 capa
    [RFW26.csv, RFW26.dsn, RFW26.kicad_pcb, RFW26.kicad_sch, RFW26_1capa.dsn, RFW26_2Capas.kicad_pcb, RFW26_2Capas.kicad_sch]
2025-01-16 correciones RFW26
    [RFW26.kicad_pcb]
2025-04-24 Update PCB design parameters and remove temporary lock file
    - Increased clearance from 0.4 to 0.5 for improved signal integrity.
    - Adjusted track width from 0.4 to 0.5 and via diameter from 0.8 to 2.0 for better manufacturability.
    - Removed unnecessary lock file for antenna frequency spreadsheet.
    [RFW26_2Capas.kicad_pcb]
2025-05-02 Cambios tesseract EMI
    [Tesseract.csv, Tesseract.kicad_pcb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]
2025-05-05 Actualizacion de RFW26 a tamaño 80x45
    [RFW26_2Capas.kicad_pcb, RFW26_2Capas.kicad_sch]
2025-05-06 RFW26 2 capa 45x80
    [RFW26_2Capas.kicad_pcb]
2025-08-14 Add README.md for RFID FDX Reader project detailing system specifications, hardware components, and development status
    [RFID_FDX_Reader.kicad_sch]
2025-08-14 Add initial schematic designs for RFID FDX-B reader
    - Created minimal schematic (RFID_FDX_Reader_minimal.kicad_sch) featuring basic components: resistor, capacitor.
    - Developed a more comprehensive schematic (RFID_FDX_Reader_simple.kicad_sch) including an inductor and detailed connections.
    - Added footprint information for components in the fp-info-cache file.
    - Generated lock files for the schematic to manage concurrent editing.
    [RFID_FDX_Reader.kicad_pcb, RFID_FDX_Reader_backup.kicad_sch, RFID_FDX_Reader_fixed.kicad_sch, RFID_FDX_Reader_minimal.kicad_sch, RFID_FDX_Reader_simple.kicad_sch]
2026-02-27 Agregar archivo de configuración OpenVPN IoTcom87.ovpn y nuevo esquema para Lector RFID FDX
2026-08-31 Agregar archivos de documentación y firmware para el proyecto Lector RFID FDX
2026-08-31 Agregar archivo CLAUDE.md con guía sobre el repositorio y sus sistemas de firmware
2026-09-07 Correcciones en la migracion del comunicador
2026-09-10 Agregar función para limpiar la clave SSH cacheada y actualizar el script de instalación
2026-09-18 feat: agregar concepto UPS V2
    [UPSV2concepttocheck.kicad_sch]
2026-09-30 Refactor: mover concepto UPS V2 a Productivo
    [UPSV2concepttocheck.kicad_pcb, UPSV2concepttocheck.kicad_sch]
