IoTCloudStudio/HW_Develop/Productivo/Cloud UPS/Imagenes/PCB v1.0 - Diseño.jpg

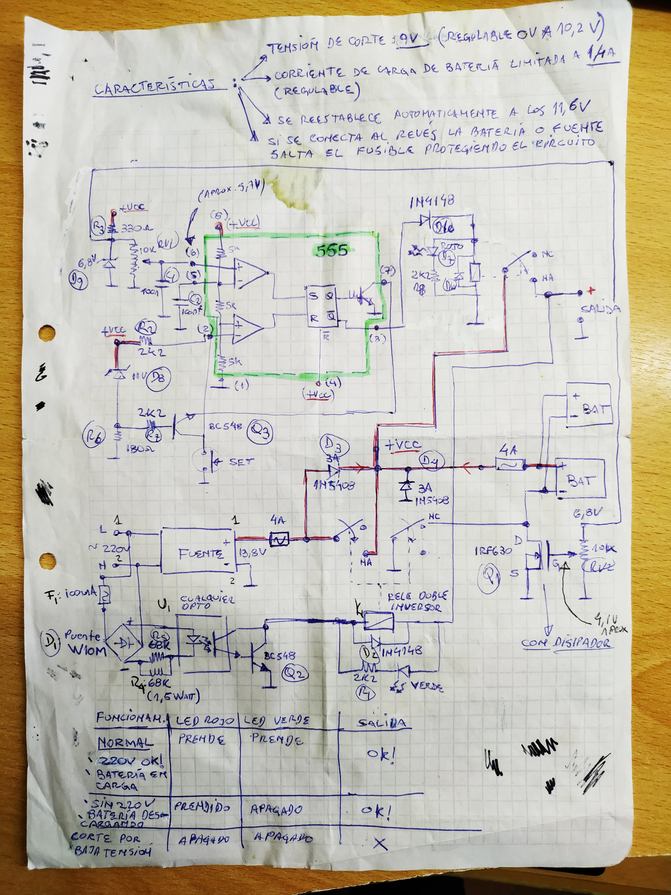
Productivo/Cloud UPS/Imagenes/PCB v1.0 - Diseño.jpg
